sang1809/SMARTFARM/phần cứng/pcb.png

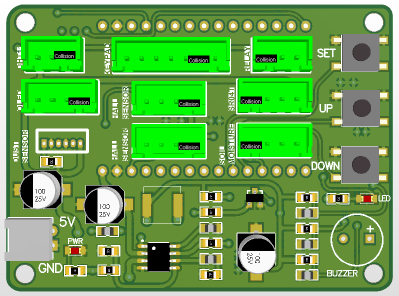
phần cứng/pcb.png
