sang1809/SMARTFARM/phần cứng/DEMO/DEMO_Project/z7310162414142_0f6232a89d1eb5eadc3b5f2d3fb466ca.jpg

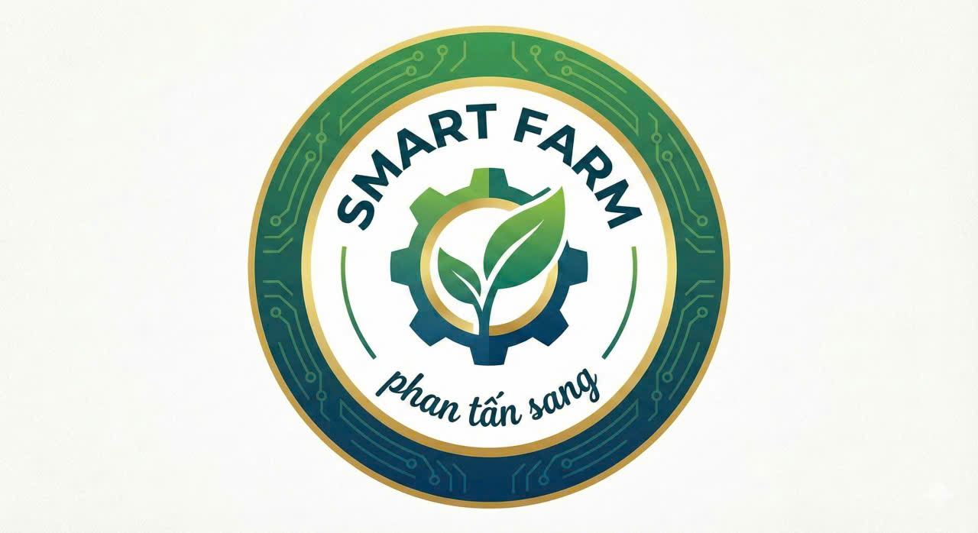
phần cứng/DEMO/DEMO_Project/z7310162414142_0f6232a89d1eb5eadc3b5f2d3fb466ca.jpg
