sang1809/SMARTFARM/phần cứng/NL.pdf

# INPUT

# BLOCK DIAGRAM

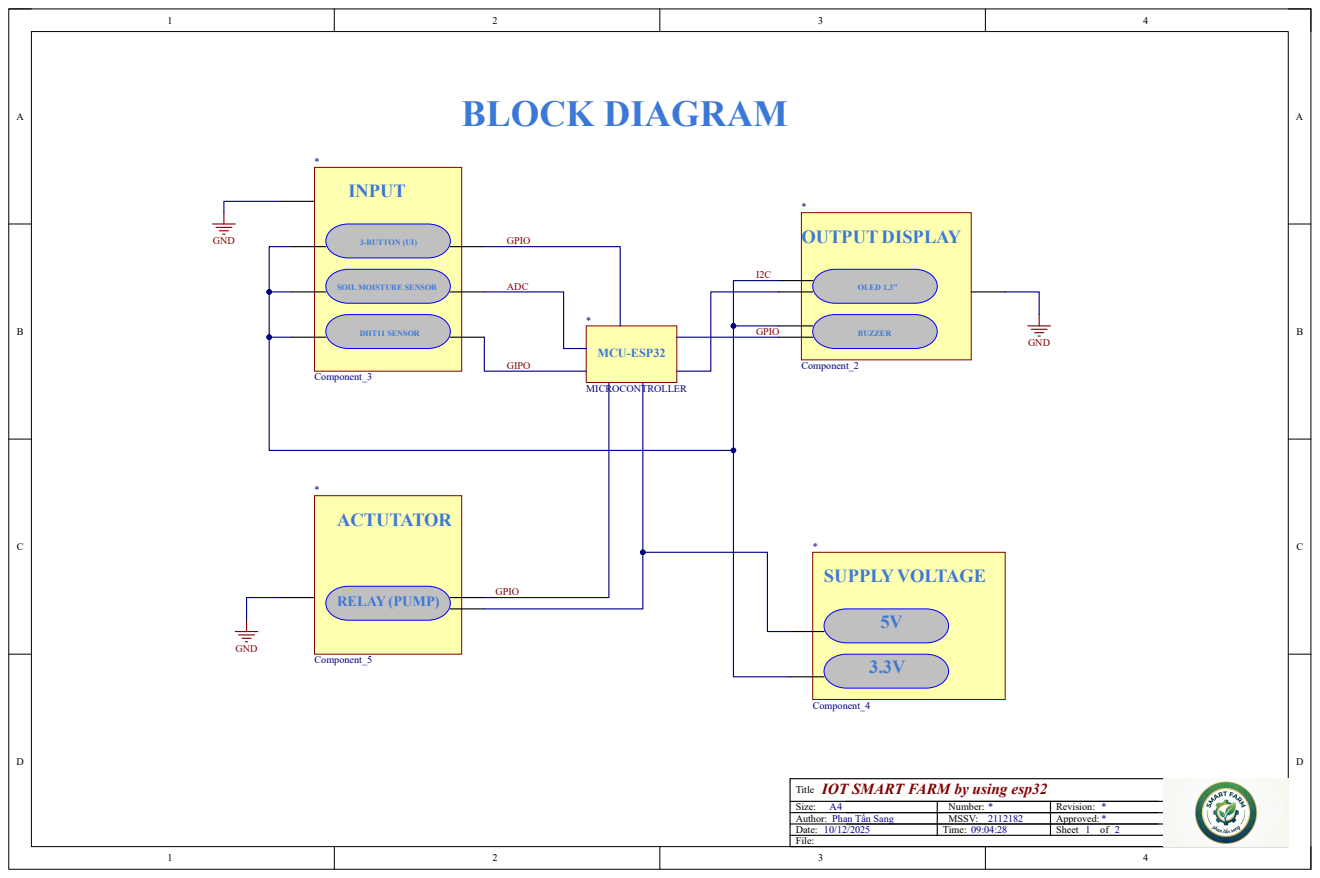
[picture p27: page 1]
File:; MCU-ESP32; MICROCONTROLLER; DHT11 SENSOR; 3-BUTTON (UI); Component_3; SUPPLY VOLTAGE; Component_4; RELAY (PUMP); ACTUTATOR; Component_5; GND; GPIO; ADC; GIPO; BUZZER; OLED 1.3''; OUTPUT DISPLAY; Component_2

SOIL MOISTURE SENSOR

IOT SMART FARM by using esp32
Title

Size: A4 | Number: * | Revision: *
Author: Phan Tấn Sang | MSSV: 2112182 | Approved: *
Date: 10/12/2025 | Time: 09:04:28 | Sheet 1 2 of

1k 1 2

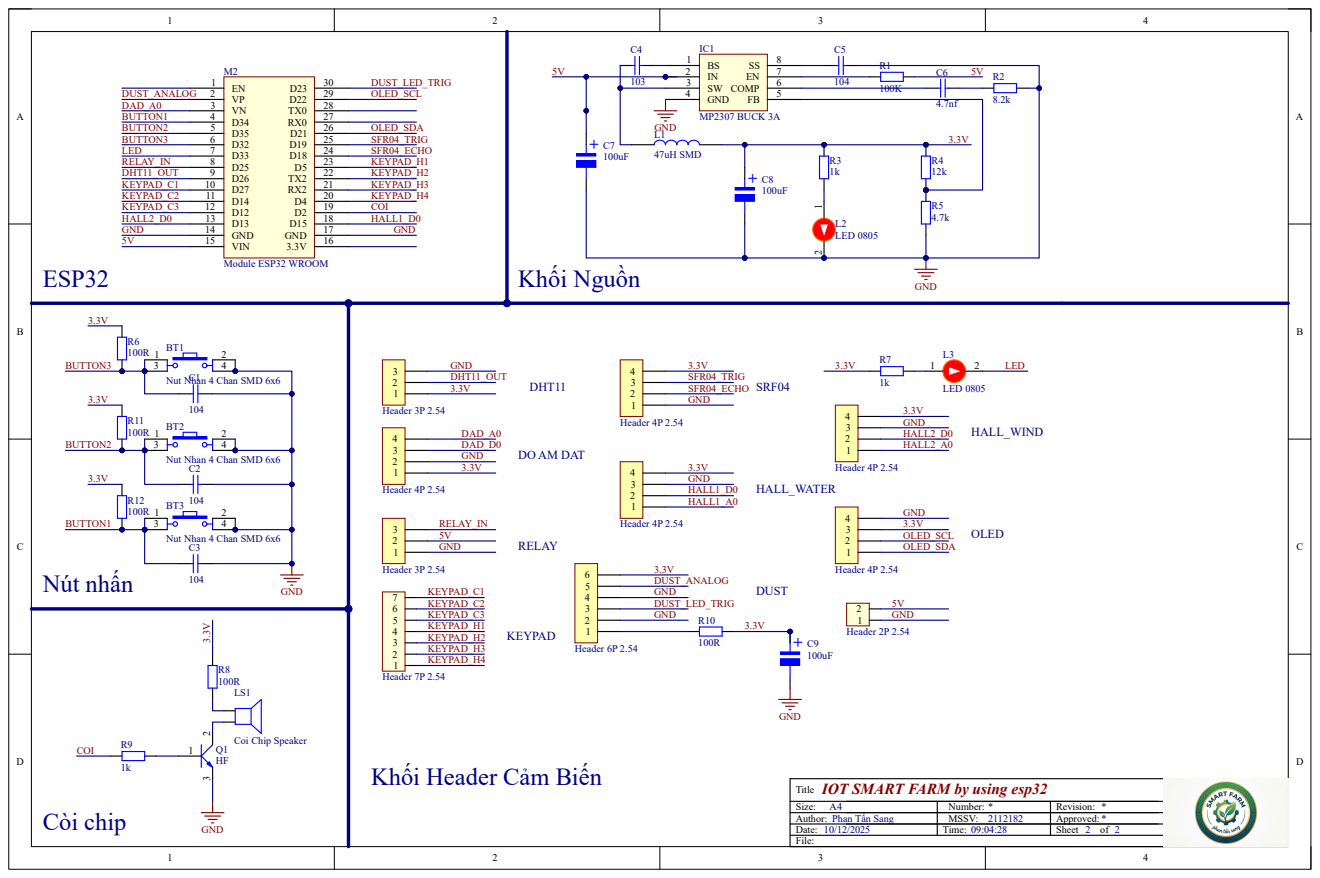
[picture p28: page 2]

Khối Header Cảm Biến

IOT SMART FARM by using esp32
Title

Size: A4 | Number: * | Revision: *
Author: Phan Tấn Sang | MSSV: 2112182 | Approved: *
Date: 10/12/2025 | Time: 09:04:28 | Sheet 2 2 of
