sang1809/SMARTFARM/phần cứng/LAYOUTBOTTOM.pdf

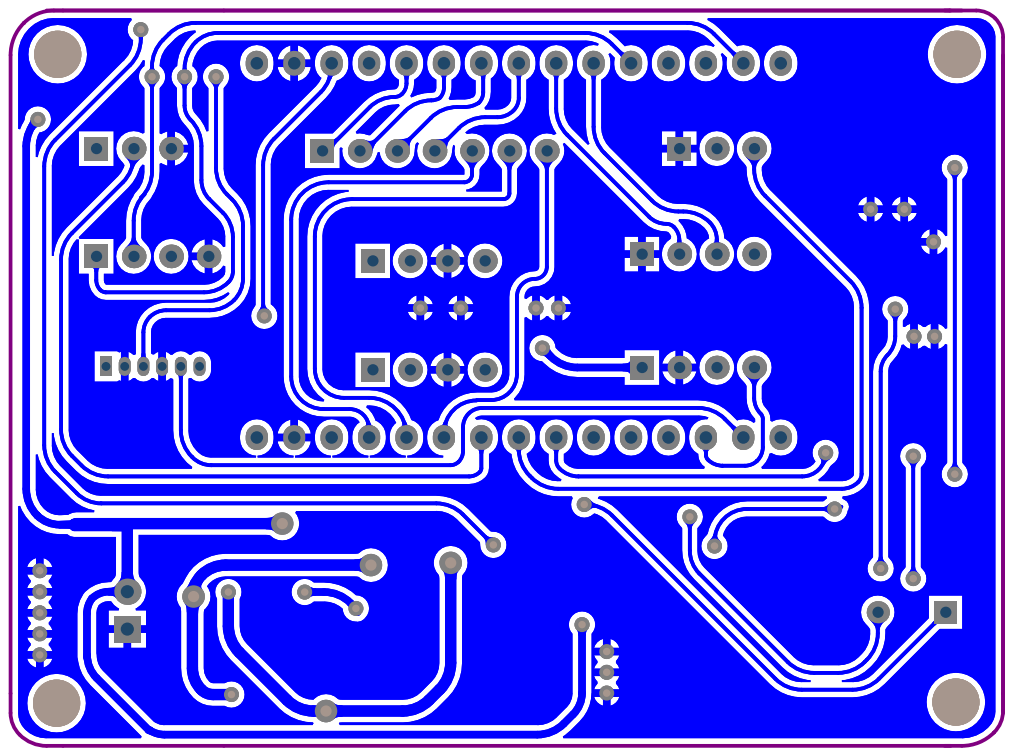
[picture p29: page 1]
