sang1809/SMARTFARM/phần cứng/LAYOUTTOP.pdf

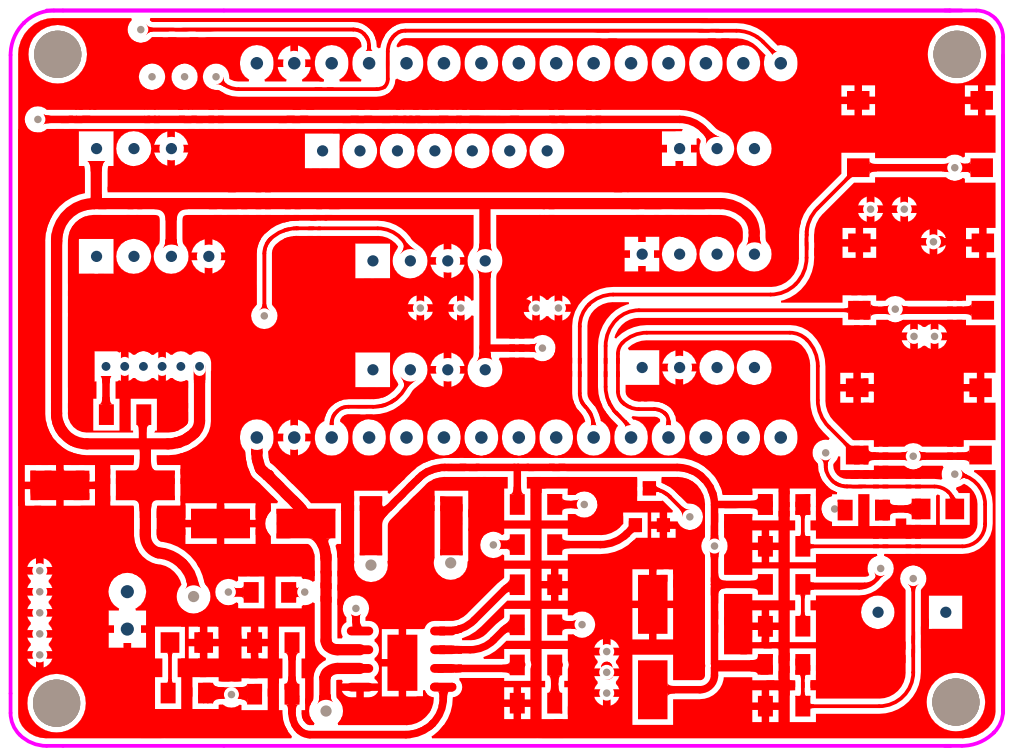
[picture p30: page 1]
