sang1809/SMARTFARM/(list of files, drawings)

Other design files:
phần cứng/DEMO/DEMO_Project/BLOCKDIAGRAM.SchDoc
phần cứng/DEMO/DEMO_Project/DEMO_Project.PrjPcb
phần cứng/DEMO/DEMO_Project/pcb.pcbdoc
phần cứng/DEMO/DEMO_Project/sche_shield_esp32_5prj.schdoc
