sang1809/SMARTFARM/icon.h

// 'PM2.5', 32x32px
const unsigned char bitmap_Temp [] PROGMEM = {
	0x00, 0x00, 0x00, 0x00, 0x00, 0x0f, 0x00, 0x00, 0x00, 0x1f, 0x80, 0x00, 0x00, 0x18, 0xc0, 0x00, 
	0x00, 0x30, 0xcf, 0x80, 0x00, 0x30, 0xcf, 0x80, 0x00, 0x30, 0xc0, 0x00, 0x00, 0x30, 0xc0, 0x00, 
	0x00, 0x30, 0xcf, 0x80, 0x00, 0x30, 0xc7, 0x00, 0x00, 0x30, 0xc0, 0x00, 0x00, 0x32, 0xcf, 0x80, 
	0x00, 0x36, 0xcf, 0x80, 0x00, 0x36, 0xc0, 0x00, 0x00, 0x36, 0xc0, 0x00, 0x00, 0x36, 0xc7, 0x80, 
	0x00, 0x36, 0xc7, 0x80, 0x00, 0x36, 0xc0, 0x00, 0x00, 0x66, 0x70, 0x00, 0x00, 0xcf, 0x30, 0x00, 
	0x01, 0x9f, 0xd8, 0x00, 0x01, 0xbf, 0xc8, 0x00, 0x01, 0x3f, 0xec, 0x00, 0x01, 0x3f, 0xec, 0x00, 
	0x01, 0x3f, 0xec, 0x00, 0x01, 0xbf, 0xc8, 0x00, 0x01, 0x9f, 0xd8, 0x00, 0x00, 0xcf, 0xb8, 0x00, 
	0x00, 0xe0, 0x70, 0x00, 0x00, 0x3f, 0xe0, 0x00, 0x00, 0x1f, 0x80, 0x00, 0x00, 0x00, 0x00, 0x00
};
const unsigned char bitmap_Humi [] PROGMEM = {
	// 'humidity-icon-512x419-5m7ztixz, 32x32px
	0x00, 0x00, 0x0f, 0xf8, 0x00, 0x00, 0x7f, 0xff, 0x00, 0x01, 0xff, 0xff, 0x00, 0x03, 0xf0, 0x06, 
	0xf0, 0x0f, 0xc0, 0x00, 0xff, 0xff, 0x00, 0x00, 0x7f, 0xfc, 0x1f, 0xfc, 0x1f, 0xf0, 0x7f, 0xff, 
	0x00, 0x01, 0xff, 0xff, 0x00, 0x07, 0xe0, 0x02, 0xf0, 0x1f, 0x80, 0x60, 0xff, 0xff, 0x00, 0x70, 
	0x7f, 0xfc, 0x10, 0xf8, 0x0f, 0xe0, 0xf9, 0xf8, 0x00, 0x01, 0xf1, 0xfc, 0x40, 0x07, 0xe3, 0x9c, 
	0xf8, 0x1f, 0x87, 0x8e, 0xff, 0xfe, 0x07, 0x0e, 0x3f, 0xfc, 0x07, 0x07, 0x07, 0xe0, 0x0e, 0x07, 
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
};
