sang1809/SMARTFARM/(commit log)

2025-12-10 thiết kế phần cứng
    [BLOCKDIAGRAM.SchDoc, pcb.pcbdoc, sche_shield_esp32_5prj.schdoc]
2025-12-10 Create phần cứng
2025-12-10 phần mềm
2025-12-10 video chạy thử
